MaazKhurram/WalkEZ/Overview of circuit compression.jpg

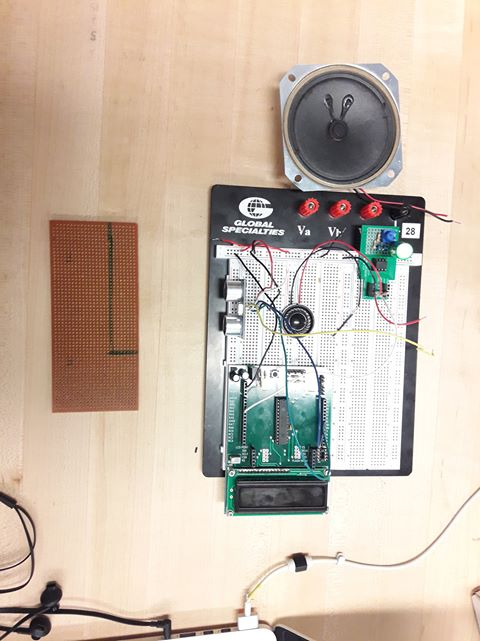
Overview of circuit compression.jpg
