MaazKhurram/WalkEZ/3DPrinting/Handle design rev1.jpg

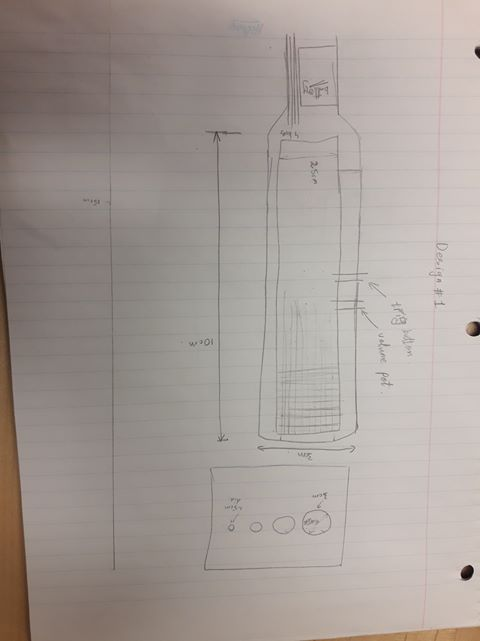
3DPrinting/Handle design rev1.jpg
