MaazKhurram/WalkEZ/README.md

# WalkEZ
A module attachable to the white cane for audio feedback to visually impaired people.
