MaazKhurram/WalkEZ/Thoughts.rtf

—> the internal diameter can be largest on the handle side allowing more space to put in the circuit boards.
the internal diameter should be the most on the sensor end to provide sturdiness . The only downside is that there centre of gravity will be closer to the lower end( sensor side of the stick ) which is good because stick has less chances to break . However it will be difficult to swipe since more weight is at the bottom.

—> I am thinking of fixing external diameter on the handle side to be 2.1cm

—> also have to think about the handle lengths of the cane. thinking if 10 cm is a good choice?

—> things that should go inside the handle:
- power supply circuit
- PIC
- Op-Amp + filters (optional)
- SD Card module
- search trigger (ON the lower end of handle )

- vibrator

—> things that go on the external handle:
- speaker
- battery holder
- volume POT
- power switch
