MaazKhurram/WalkEZ/Independent Power Supply/Supply_progress_day7.rtf

To do/ Concerns:

In Progress:

Done:

Reviewed:
—> How much current does the PIC take?
—> Learn how to design a more complex power supply.
—> How much area can the assembly take at max to fit inside the 3D model?
