MaazKhurram/WalkEZ/3DPrinting/3Dprogress_day6.rtf

To do/ Concerns:

In Progress:

—>mechanism to protect+secure sensors at the tip

Done:
—> Calculate the area needed for the independent supply+ 9V battery+ PIC module + search mode trigger
—> decide what kind of interlocking mechanism needed between parts
—> Decide the logo of the product

Reviewed:
—> calculate width of the 4 wire bus
—> how big is the 9V battery holder?
—> decide diameters on handle end
—> Think about SD replacement
—> think about the battery replacement area.
—>Decide diameter of sensor end
