MaazKhurram/WalkEZ/3DPrinting/3Dprogress_day4.rtf

To do/ Concerns:

4. decide what kind of interlocking mechanism needed between parts
5. Decide the logo of the product
6. mechanism to protect+secure sensors at the tip

In Progress:

—> Calculate the area needed for the independent supply+ 9V battery+ PIC module + search mode trigger
—> think about the battery replacement area.

—>Decide diameter of sensor end

Done:
—> calculate width of the 4 wire bus
—> how big is the 9V battery holder?
—> decide diameters on handle end
—> Think about SD replacement

Reviewed:
