MaazKhurram/WalkEZ/3DPrinting/3Dprogress_day3.rtf

To do/ Concerns:

1. think about the battery replacement area.
2. Think about SD replacement
4. decide what kind of interlocking mechanism needed between parts
5. Decide the logo of the product
6. mechanism to protect+secure sensors at the tip
7. calculate width of the 4 wire bus
8 . Calculate the area needed for the SD card module + independent supply+ 9V battery+ PIC module + search mode trigger+ amplifier and filters

In Progress:

—> Calculate the area needed for the SD card module + independent supply+ 9V battery+ PIC module + search mode trigger

—> how big is the 9V battery holder?
—>Decide diameter of both ends

Done:
—> calculate width of the 4 wire bus

Reviewed:
