MaazKhurram/WalkEZ/Independent Power Supply/Supply_progress_day3.rtf

To do/ Concerns:

In Progress:

—> How much area can the assembly take at max to fit inside the 3D model?

Done:
—> How much current does the PIC take?
—> Learn how to design a more complex power supply.

Reviewed:
