MaazKhurram/WalkEZ/Independent Power Supply/Supply_progress_day1.rtf

To do/ Concerns:

1. How much current does the PIC take?
2. Learn how to design a more complex power supply.
3. How much area can the assembly take at max to fit inside the 3D model?

In Progress:

—> How much current does the PIC take?
—> Learn how to design a more complex power supply.

Done:

Reviewed:
