MaazKhurram/WalkEZ/3DPrinting/Handle design rev2.jpg

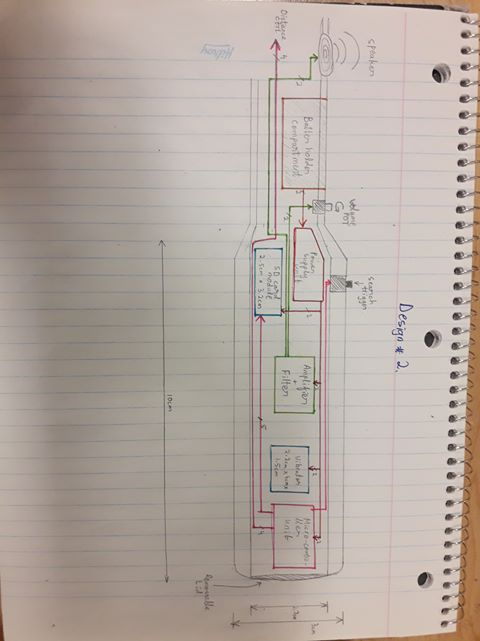
3DPrinting/Handle design rev2.jpg
