MaazKhurram/WalkEZ/High level Schematic.png

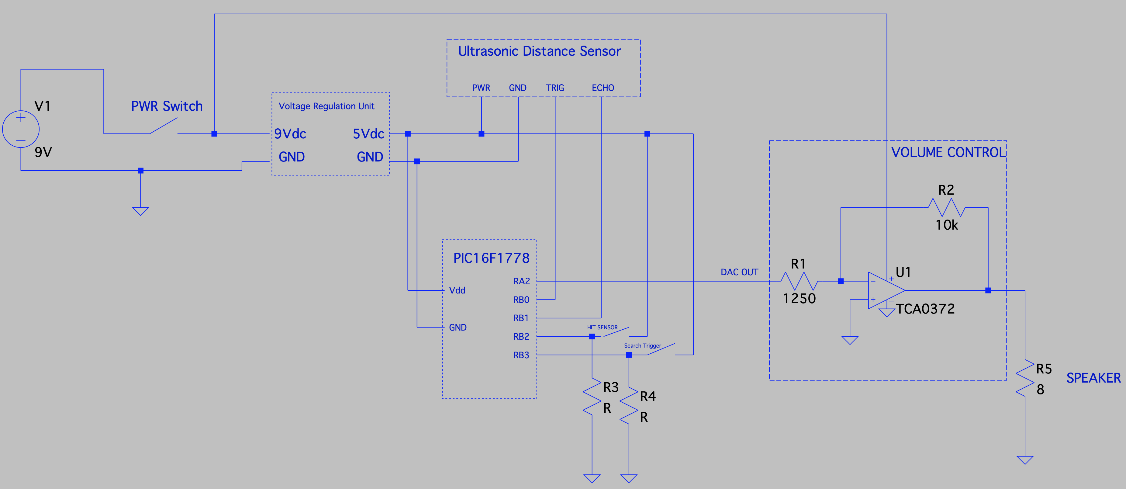
High level Schematic.png
