MaazKhurram/WalkEZ/Amplifier + filters/Materials needed Amp.txt

Materials needed;

--> TLV41121 Op- amp 
--> one resistor 
--> one potentiometer
