MaazKhurram/WalkEZ/Independent Power Supply/Supply_Materials needed.txt

Materials needed;

--> prototype board
--> voltage regulator
--> two capacitors probably
--> 9 V battery holder with cover
-->
