MaazKhurram/WalkEZ/3DPrinting/Materials needed 3D.txt

Materials needed;

--> filaments 
--> .obj files or probably gcode
