MaazKhurram/WalkEZ/3DPrinting/3D_design__files/Intermediate tube designs/INTERMEDIATE3 rev1 group_attemp1.stl

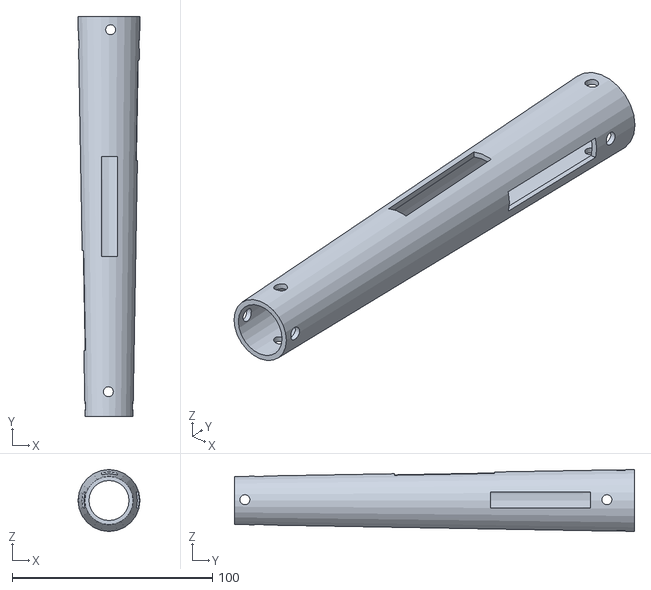
[picture p15: CAD file, 2019-05-05]
3DPrinting/3D_design__files/Intermediate tube designs/INTERMEDIATE3 rev1 group_attemp1.stl
31.0 x 200.0 x 31.0
