MaazKhurram/WalkEZ/3DPrinting/3D_design__files/Lower tip designs/SENSOR END rev2 group_attempt1.stl

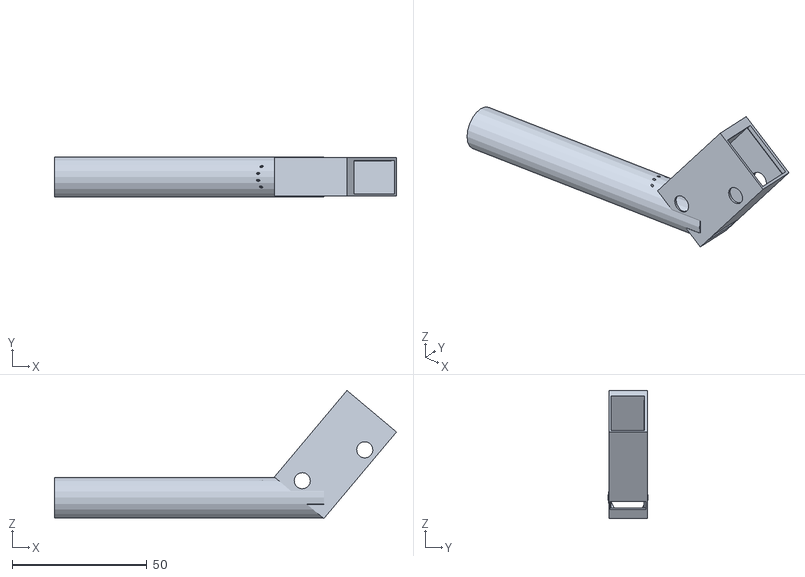
[picture p16: CAD file, 2019-05-05]
3DPrinting/3D_design__files/Lower tip designs/SENSOR END rev2 group_attempt1.stl
127.0 x 15.0 x 47.6
