MaazKhurram/WalkEZ/3DPrinting/3D_design__files/Handle Designs/HANDLE END rev3 ungroup.stl

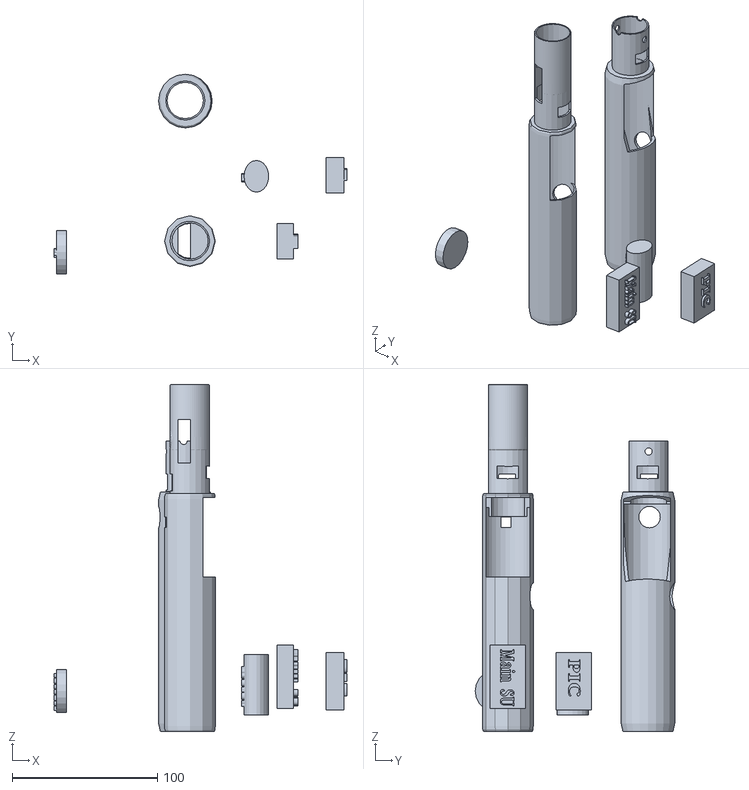
[picture p17: CAD file, 2019-05-05]
3DPrinting/3D_design__files/Handle Designs/HANDLE END rev3 ungroup.stl
201.6 x 137.5 x 239.0
