MaazKhurram/WalkEZ/3DPrinting/3D_design__files/Intermediate tube designs/INTERMEDIATE1 rev1 group_attemp1.stl

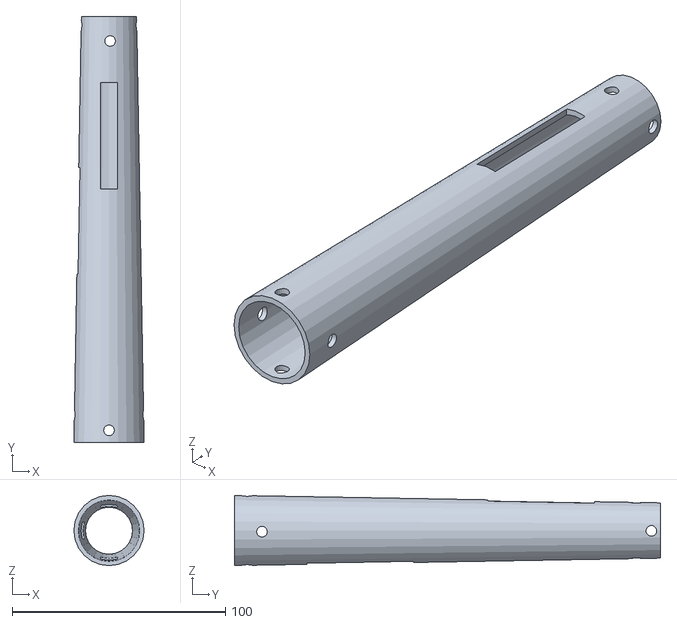
[picture p18: CAD file, 2019-05-05]
3DPrinting/3D_design__files/Intermediate tube designs/INTERMEDIATE1 rev1 group_attemp1.stl
33.0 x 200.0 x 33.0
