MaazKhurram/WalkEZ/3DPrinting/3D_design__files/Lower tip designs/SENSOR END rev2 ungroup.stl

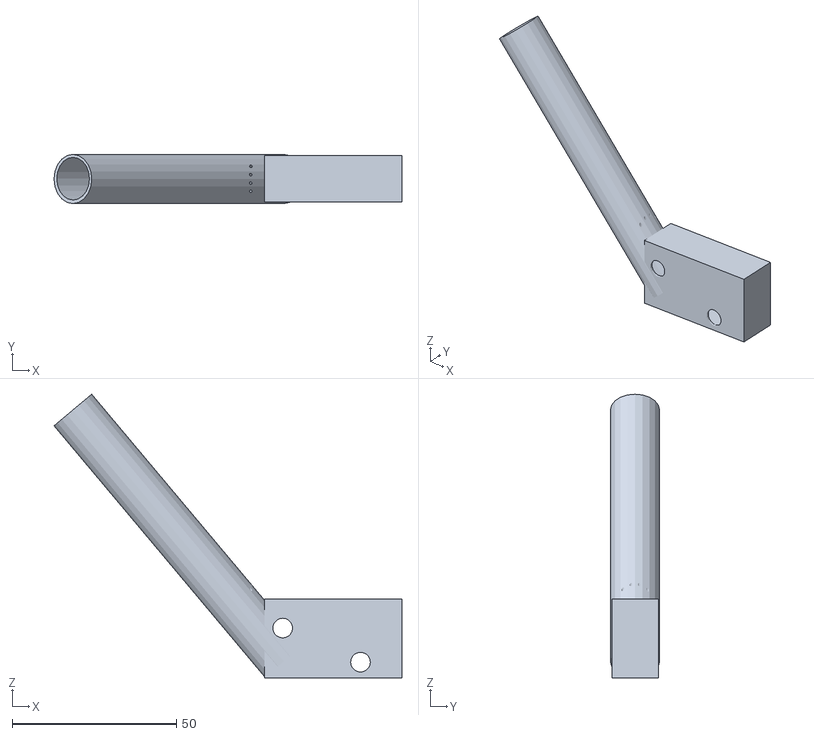
[picture p19: CAD file, 2019-05-05]
3DPrinting/3D_design__files/Lower tip designs/SENSOR END rev2 ungroup.stl
106.0 x 15.0 x 86.4
