MaazKhurram/WalkEZ/3DPrinting/3D_design__files/Handle Designs/HANDLE END rev3 group_attempt1.stl

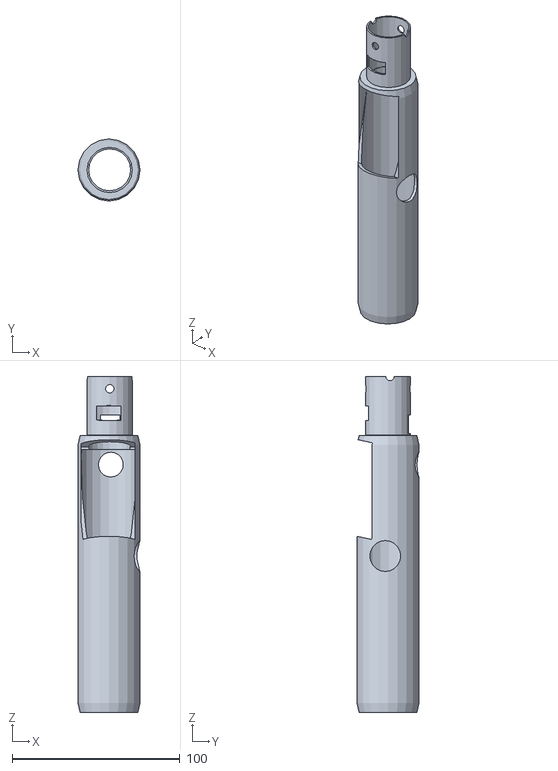
[picture p20: CAD file, 2019-05-05]
3DPrinting/3D_design__files/Handle Designs/HANDLE END rev3 group_attempt1.stl
37.0 x 37.0 x 200.2
