MaazKhurram/WalkEZ/3DPrinting/3D_design__files/Intermediate tube designs/INTERMEDIATE4 rev1 group_attemp1.stl

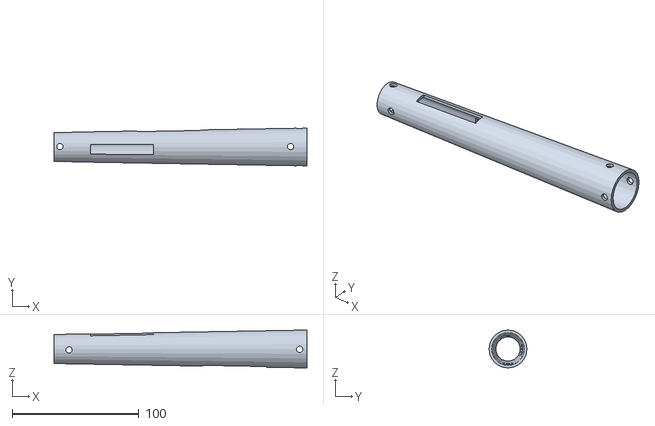
[picture p21: CAD file, 2019-05-05]
3DPrinting/3D_design__files/Intermediate tube designs/INTERMEDIATE4 rev1 group_attemp1.stl
200.0 x 30.0 x 30.0
