MaazKhurram/WalkEZ/3DPrinting/3D_design__files/Lower tip designs/SENSOR END rev2 group_attempt2.stl

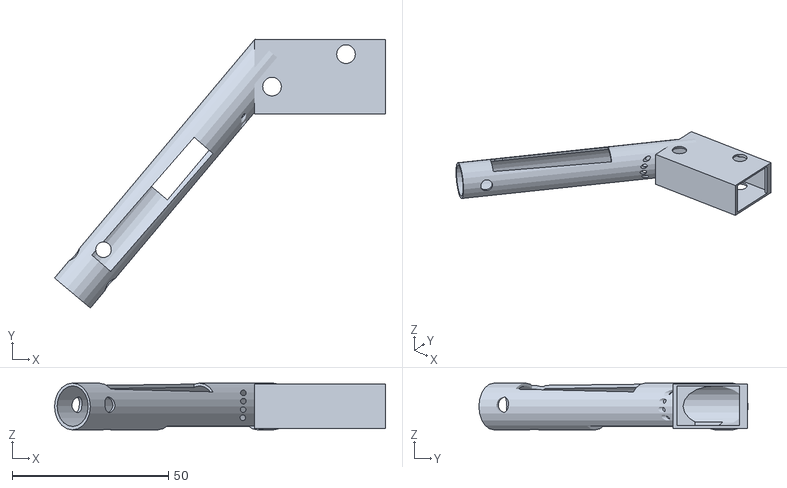
[picture p22: CAD file, 2019-05-05]
3DPrinting/3D_design__files/Lower tip designs/SENSOR END rev2 group_attempt2.stl
106.0 x 86.2 x 15.0
