MaazKhurram/WalkEZ/3DPrinting/3D_design__files/Handle Designs/HANDLE END rev2 group_ attempt2.stl

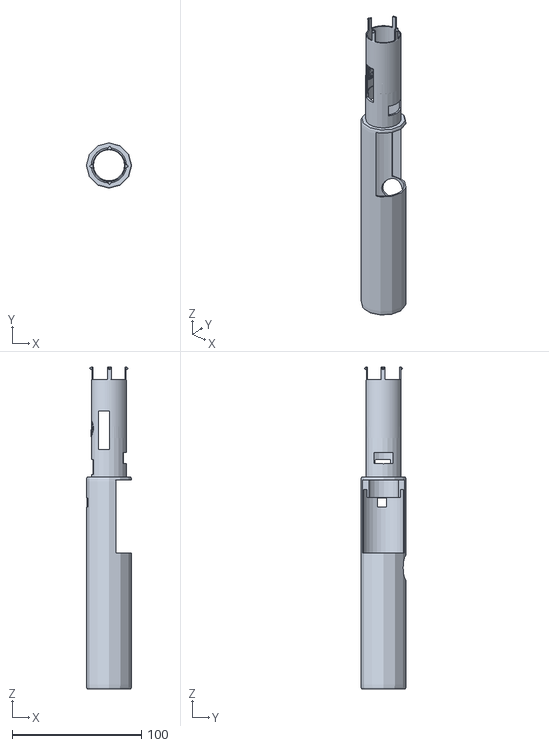
[picture p23: CAD file, 2019-05-05]
3DPrinting/3D_design__files/Handle Designs/HANDLE END rev2 group_ attempt2.stl
35.0 x 35.0 x 248.8
