MaazKhurram/WalkEZ/3DPrinting/3D_design__files/Lower tip designs/SENSOR END rev1 group_attemp1.stl

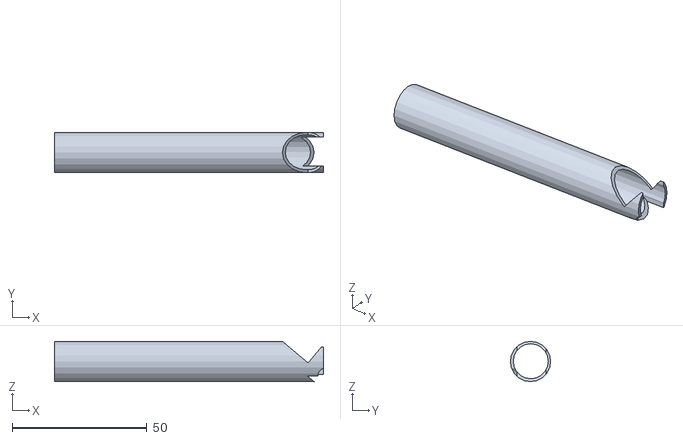
[picture p25: CAD file, 2019-05-05]
3DPrinting/3D_design__files/Lower tip designs/SENSOR END rev1 group_attemp1.stl
100.0 x 15.0 x 15.0
