MaazKhurram/WalkEZ/3DPrinting/3D_design__files/Intermediate tube designs/INTERMEDIATE6 rev1 group_attemp1.stl

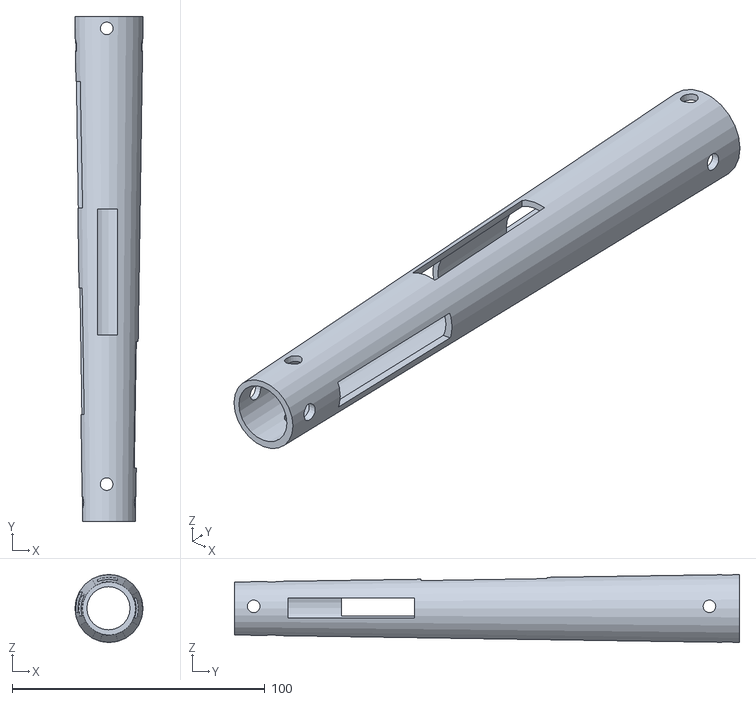
[picture p26: CAD file, 2019-05-05]
3DPrinting/3D_design__files/Intermediate tube designs/INTERMEDIATE6 rev1 group_attemp1.stl
27.0 x 200.0 x 27.0
