MaazKhurram/WalkEZ/3DPrinting/3D_design__files/Intermediate tube designs/INTERMEDIATE2 rev1 ungroup.stl

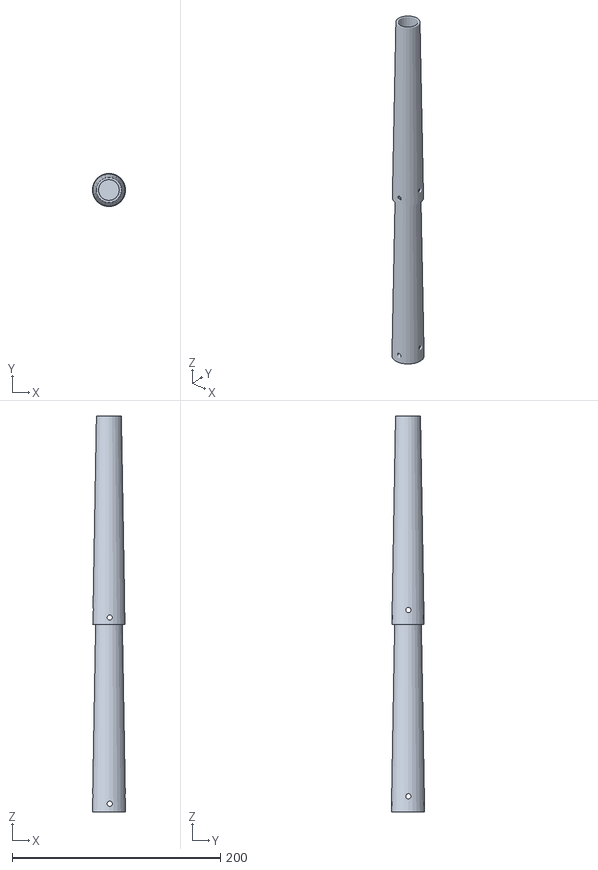
[picture p27: CAD file, 2019-05-05]
3DPrinting/3D_design__files/Intermediate tube designs/INTERMEDIATE2 rev1 ungroup.stl
32.0 x 32.0 x 380.0
