MaazKhurram/WalkEZ/3DPrinting/3D_design__files/Intermediate tube designs/INTERMEDIATE5 rev1 group_attemp1.stl

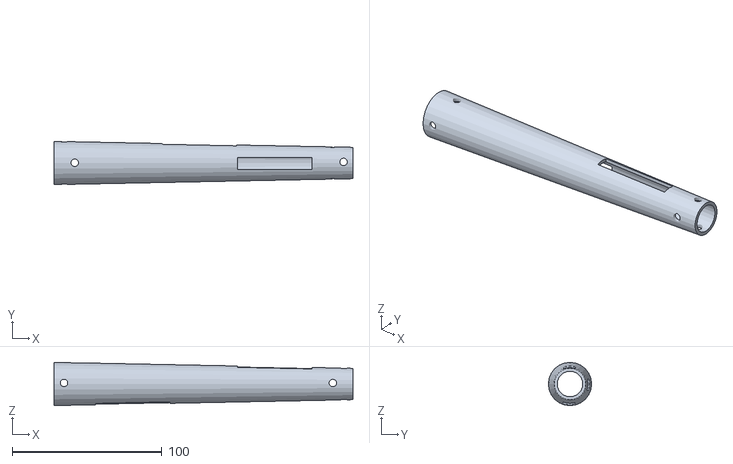
[picture p28: CAD file, 2019-05-05]
3DPrinting/3D_design__files/Intermediate tube designs/INTERMEDIATE5 rev1 group_attemp1.stl
200.0 x 29.0 x 29.0
