MaazKhurram/WalkEZ/3DPrinting/3D_design__files/Intermediate tube designs/INTERMEDIATE1 rev1 ungroup.stl

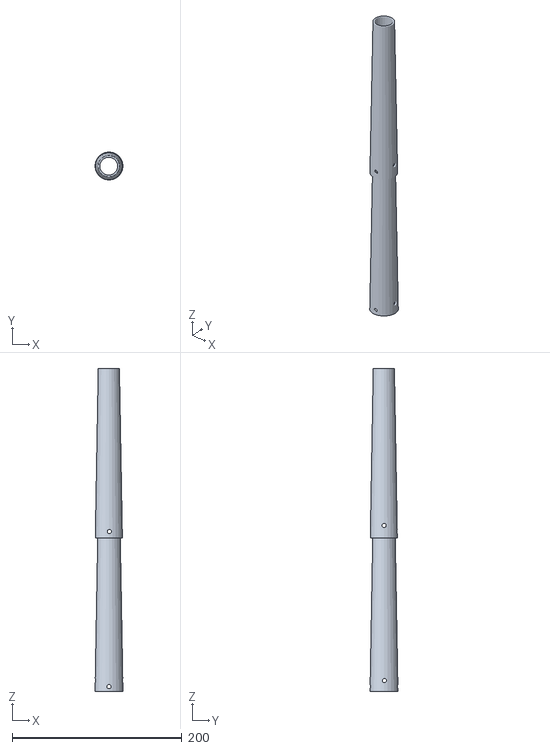
[picture p29: CAD file, 2019-05-05]
3DPrinting/3D_design__files/Intermediate tube designs/INTERMEDIATE1 rev1 ungroup.stl
33.0 x 33.0 x 380.6
