MaazKhurram/WalkEZ/3DPrinting/3D_design__files/Intermediate tube designs/INTERMEDIATE4 rev1 ungroup.stl

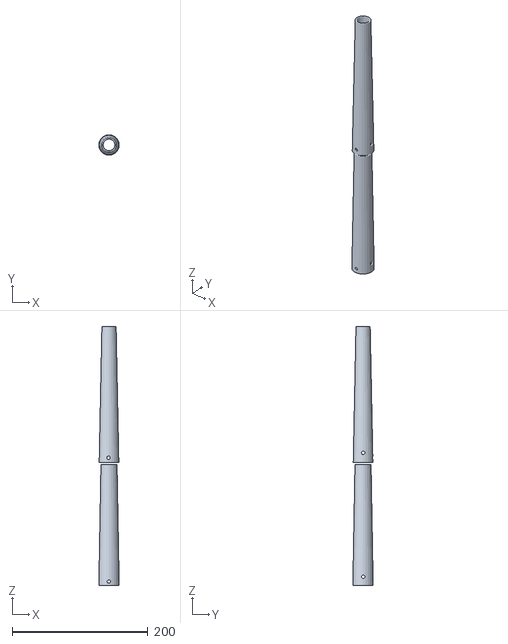
[picture p30: CAD file, 2019-05-05]
3DPrinting/3D_design__files/Intermediate tube designs/INTERMEDIATE4 rev1 ungroup.stl
30.0 x 30.0 x 381.4
