MaazKhurram/WalkEZ/3DPrinting/3D_design__files/Intermediate tube designs/INTERMEDIATE5 rev1 ungroup.stl

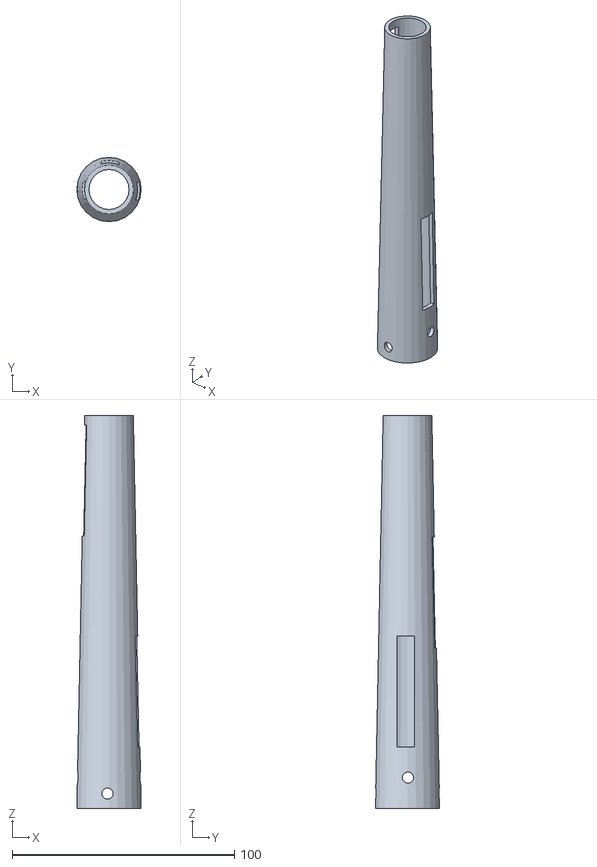
[picture p31: CAD file, 2019-05-05]
3DPrinting/3D_design__files/Intermediate tube designs/INTERMEDIATE5 rev1 ungroup.stl
29.0 x 29.0 x 176.8
