MaazKhurram/WalkEZ/3DPrinting/3D_design__files/Intermediate tube designs/INTERMEDIATE6 rev1 ungroup.stl

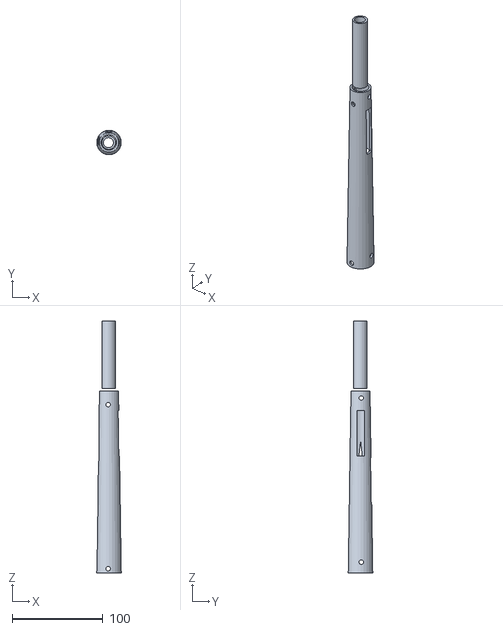
[picture p32: CAD file, 2019-05-05]
3DPrinting/3D_design__files/Intermediate tube designs/INTERMEDIATE6 rev1 ungroup.stl
27.0 x 27.0 x 277.1
