MaazKhurram/WalkEZ/3DPrinting/3D_design__files/Intermediate tube designs/INTERMEDIATE3 rev1 ungroup.stl

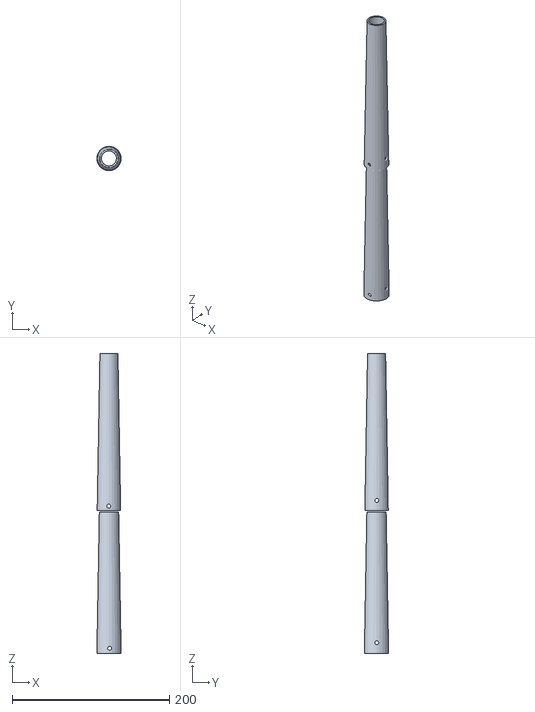
[picture p33: CAD file, 2019-05-05]
3DPrinting/3D_design__files/Intermediate tube designs/INTERMEDIATE3 rev1 ungroup.stl
31.0 x 31.0 x 381.8
