MaazKhurram/WalkEZ/(list of files, cad)

Other CAD files:
3DPrinting/3D_design__files/Handle Designs/HANDLE END rev1 ungroup.stl
3DPrinting/3D_design__files/Handle Designs/HANDLE END rev2 group_attempt1.stl
3DPrinting/3D_design__files/Handle Designs/HANDLE END rev2 ungroup.stl
3DPrinting/3D_design__files/Lower tip designs/SENSOR END rev1 ungroup.stl
