MaazKhurram/WalkEZ/WalkEZ User Manual.docx

WalkEZ User Manual

Description:

- The WalkEZ cane is designed to help the visually impaired to navigate with the help of auditory warnings.
- The WalkEZ will generate a distance warning tone when activated based on obstacles 1 meter in front of the cane.
- High pitch, high volume = Obstacle is close
- Low pitch, low volume = Obstacle is far

Usage Instruction:

1. Place a 9 Volt battery in the battery compartment

2. Tap or hold the either the pulse or the search button

3. Adjust the volume using the volume knob to a comfortable range

4. Navigate by using the auditory warnings

Modes:

Pulse Mode: Tapping the Pulse button generates a singular distance warning. Holding will not generate additional warnings.

Search Mode: Holding will continuously generate distance warnings. Has precedence over pulse mode.
