MaazKhurram/WalkEZ/Amplifier + filters/Volume Control Design.asc

C1: cap
R1: res
R2: res
R3: res
Speaker: res; 8
U1: opamp2
V1: voltage
V2: voltage
VOL_CTRL: pot
X1: pot
Named nets: 0
Secondary Supply  
         Unit
DAC input
Volume Contol Unit
