MaazKhurram/WalkEZ/Amplifier + filters/pot.asc

R1: res; {Ra}
R2: res; {Rb}
Named nets: 1, 2, 3
.param Ra=R*(val/100)
.param Rb=R*(1-(val/100))
