MaazKhurram/WalkEZ/(commit log)

2019-04-08 added text files to keep track of the project
2019-04-08 updated materials needed and tasks for day 1
2019-04-09 update after day 1 . New files for day 2
    [White cane design rev1.stl]
2019-04-11 Updates for the 3rd day
    [Handle Design Rev1.stl]
2019-04-11 Reduced length of Sine_Sample. Increased frequency range of sensors. Changed to using only 8 bits of the 10 bit DAC to accomodate 8 bit short Sine_Sample. Interrupt turned out to be slower than PLAY_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
2019-04-11 There's some clipping at voltages near 0. Reduced sensor detection range to be less than 1 meter to ensure accurate readings being converted into audio. Distances beyond 1 meter will no longer genera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
2019-04-11 Changed TIMER4_WAIT() to also play audio while it waits so that there is still audio playing while the trigger pulse is being sent.
2019-04-12 Added button control for a single audio output. Holding button only produces sound once.
2019-04-13 Fixed an issue where high frequency audio would play if sensor timer timed out.
2019-04-17 fixed an issue with sensor skipping. changed max sensor range.
    [Timer.c, Timer.h, main.c]
2019-05-05 added remaining progress files for 3d printing
2019-05-05 added remaining progress files for Independent Power Supply
2019-05-05 overall Circuit Schematic at a high level
2019-05-05 filename standard == <PART_ NAME> <revision> <design_type>_<attempt no.>
    [HANDLE END rev1 ungroup.stl, HANDLE END rev2 group_ attempt2.stl, HANDLE END rev2 group_attempt1.stl, HANDLE END rev2 ungroup.stl, HANDLE END rev3 group_attempt1.stl, HANDLE END rev3 ungroup.stl, INTERMEDIATE1 rev1 group_attemp1.stl, INTERMEDIATE1 rev1 ungroup.stl]
